SARP-UW/SRAD-Flight-Computer-26-27/App/Config/config.h

// This file contains all the important values that the client may need to change based on the users preferences.

#define APOGEE_PYRO_BACKUP_DELAY_MS 2000

#define MAIN_PYRO_ALTITUDE_M 500.0f 

#define MAIN_PYRO_BACKUP_DELAY_MS 2000

#define POST_FLIGHT_LOGGING_DURATION_MS 15000

// Idle Descent State
#define LANDING_DETECTION_MAX_VELOCITY 3.0f // m/s
#define LANDING_DETECTION_INTERVAL_MS 5000U
#define LANDING_DETECTION_ACCELERATION_TOLERANCE 2.0f // m/s^2
