SARP-UW/SRAD-Flight-Computer-26-27/App/States/Inc/idle_descent.h

/**
 * @file App/States/Inc/idle_descent.h
 * @authors Michael Zheng
 * @brief Idle descent state draft
 */

#pragma once

#include "stm32f4xx_hal.h"
#include "state_machine.h"

State update_idle_descent(State_Context *context);
