SARP-UW/SRAD-Flight-Computer-26-27/(commit log)

2026-09-15 complete ms5611 driver
2026-09-18 cmake updates and start on imu driver
2026-09-18 finished draft of imu driver
2026-09-23 Minor typo fix for "idle_decent"
    [idle_descent.h]
2026-09-23 Draft for led support
2026-09-29 added accelerometer offset consideration and fixed errors in ascent state
    [ascent.c, bmi088.c, bmi088.h, state_machine.h]
2026-09-29 Support for all 5 LEDs
2026-10-06 Basic support for buzzer - Allows turning buzzer on/off/set frequency - Misc. formatting changes
    [buzzer.c, buzzer.h, init_gpio.c, led.c, led.h, ms5611.h, pinout.h]
2026-10-06 Configure CubeMX for proper PWM output to buzzer
    [SARP_SRAD_Flight_Computer.ioc]
2026-10-06 Revert changes to SPI prescaler - CubeMX automatically changed these when I updated TIM2 params, cause unknown
    [SARP_SRAD_Flight_Computer.ioc]
2026-10-12 Enable UART2 and set to asynchronous
2026-10-15 fixed imu so that it's not incorrectly adjusting for gravity or bias and updated ascent state to use baro only. Ascent state will not work properly, however, until the kalman filter is implemented
2026-10-15 Extra notes on landing detection
2026-10-16 Primary landing detection alg - Still needs a backup detection method to be implemented
2026-10-23 initial low-pass filter
2026-10-26 Low-pass-filter impl
2026-11-08 updated safe state to not have any pyro authority and added a status variable for each sensor and the kalman filter algorithm
2026-11-09 added tim4 for 10ms interrupt
2026-11-09 Buzzer interrupts on tim3
2026-11-09 Added Buzzer interrupts on Tim3
